xiaolaba/Curve_Tracer_testing/(threads)

Thread 1 (2021-10-04):

License violation

JosephEoff, 2021-10-04:
Hi.  It is rather cool that you like my software enough  to repost it with some useful batch files.

It is not so cool that you changed the license.

"Rodriguez" is licensed under  the [GNU General Public License, version 2.](https://www.gnu.org/licenses/old-licenses/gpl-2.0.en.html)

Your repository has the license set to MIT.  By the terms of the GPL, only the copyright holder (me, Joseph Eoff) can change the license.

Please change the license on the repository to GPL V2, or delete the repository.

JosephEoff, 2021-10-04:
Additionally, there is a binary build of Rodriguez in my repository ([Release 1.0.0](https://github.com/JosephEoff/Rodriguez/releases/tag/v1.0.0)) so there's no real need to provide a binary of your own.

xiaolaba, 2021-10-04:
thanks. i had delete the license and add another, please teach me whether the license is sutible one for the choice.

JosephEoff, 2021-10-04:
Thank you for fixing the license.

GPL V2.0 is the correct license.

The GPL V20 license requires that you keep the same license when using code licensed under it.  The GPL V2 license also requires that you make the code itself available to other users.  You have a link to my project in the ReadMe.  I'll accept that as "providing the source code."

You don't need to refer to this in your ReadMe.  Just keep the license as is, and make sure to always refer to my project so that others can find the most current version.

JosephEoff, 2021-10-05:
I saw that you had some trouble with negative values for the diode and collector current.

Both are caused by the same thing.

The real cause is that I swapped A2 and A3 when I drew the schematics.  That made the calculated values for the collector current come out negative.  The diode function uses the same analog inputs as the collector measurements, so that messed up the diode measurements as well.

Since you are the second person to have this problem, I changed the Arduino code to use the analog inputs as shown in the schematic diagrams.

All you need to do is to download the new Rodriguez.ino file and burn it to your Arduino.

xiaolaba, 2021-10-06:
thanks Joseph,we will try out later on when come back to town.

JosephEoff, 2021-10-13:
You will have to show me what you mean about "redundant" CRLF.

The Rodriguez Arduino part uses the [Arduino Serial.println](https://www.arduino.cc/reference/en/language/functions/communication/serial/println/) function, which always sends a CRLF at the end of each line.

It reads individual characters, ignoring line ends and reacting only to the command codes (B or C.)

The Python program uses serial.readline, which reads the lines sent to it from the Arduino.  This works correctly und Linux.  It should also work correctly under Windows.

Where are you seeing redundant CRLF?

Closed 2021-10-04.
