xiaolaba/Curve_Tracer_testing/curve tracer design reading/DIY Generic Curve Tracer - Electronics-Lab.pdf

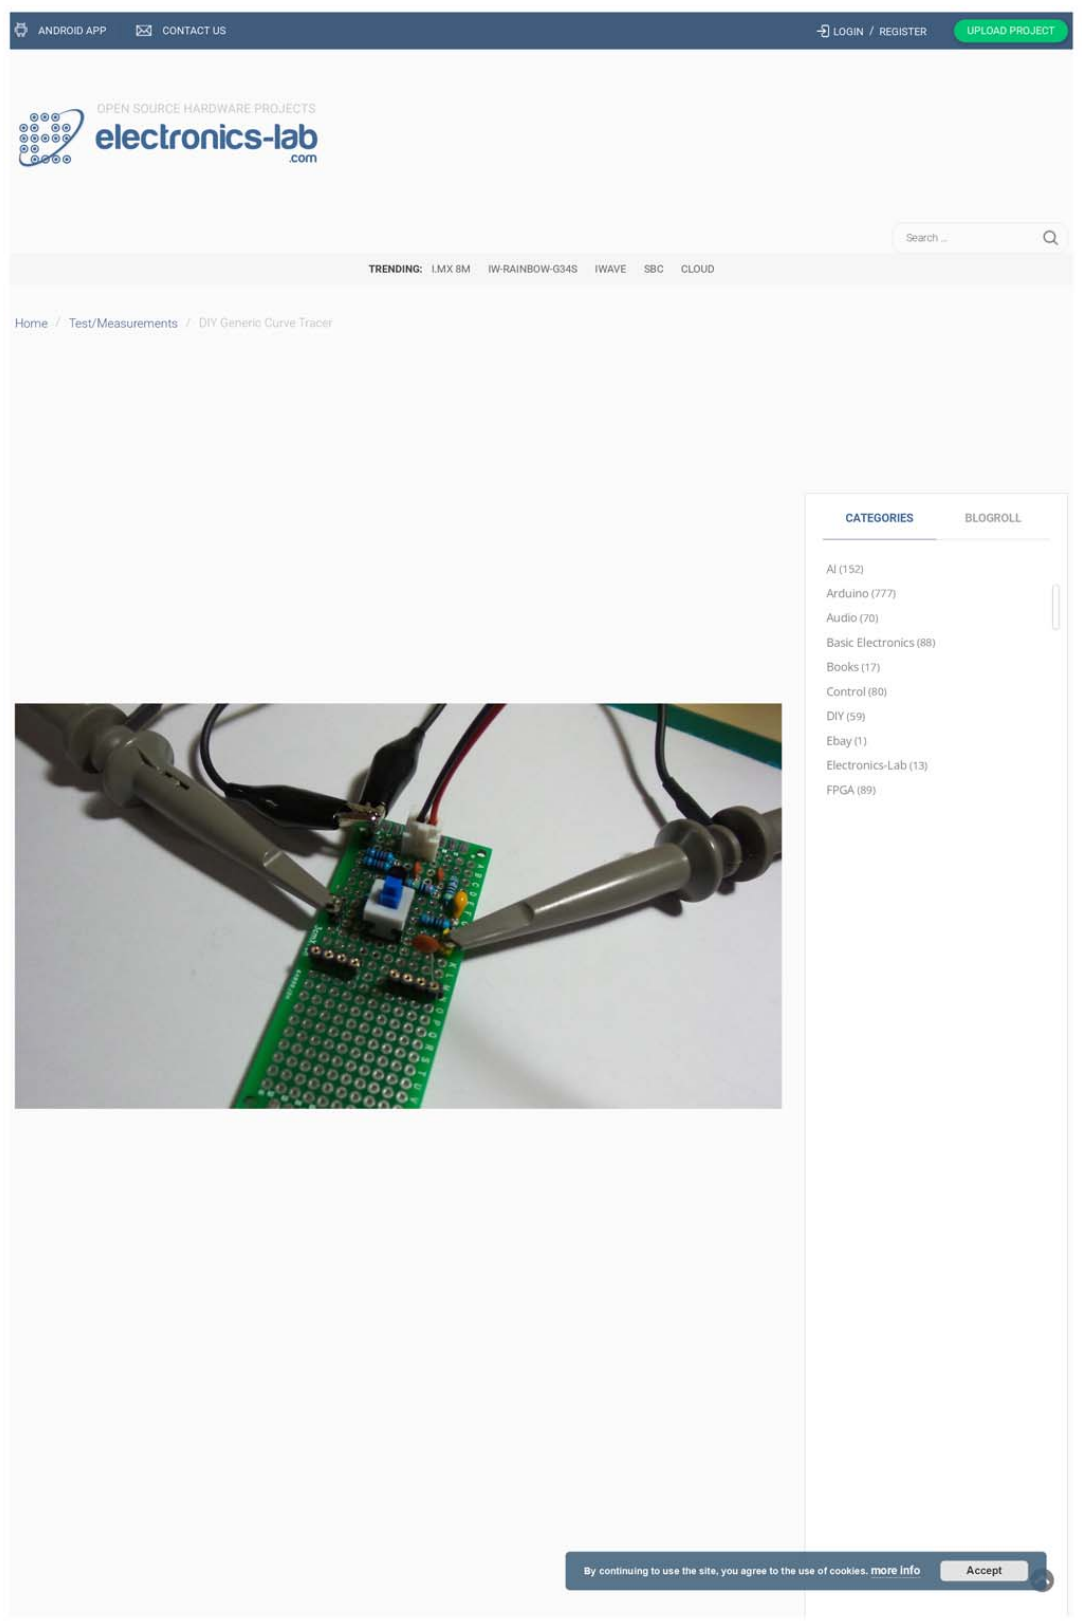
[picture p19: page 1]

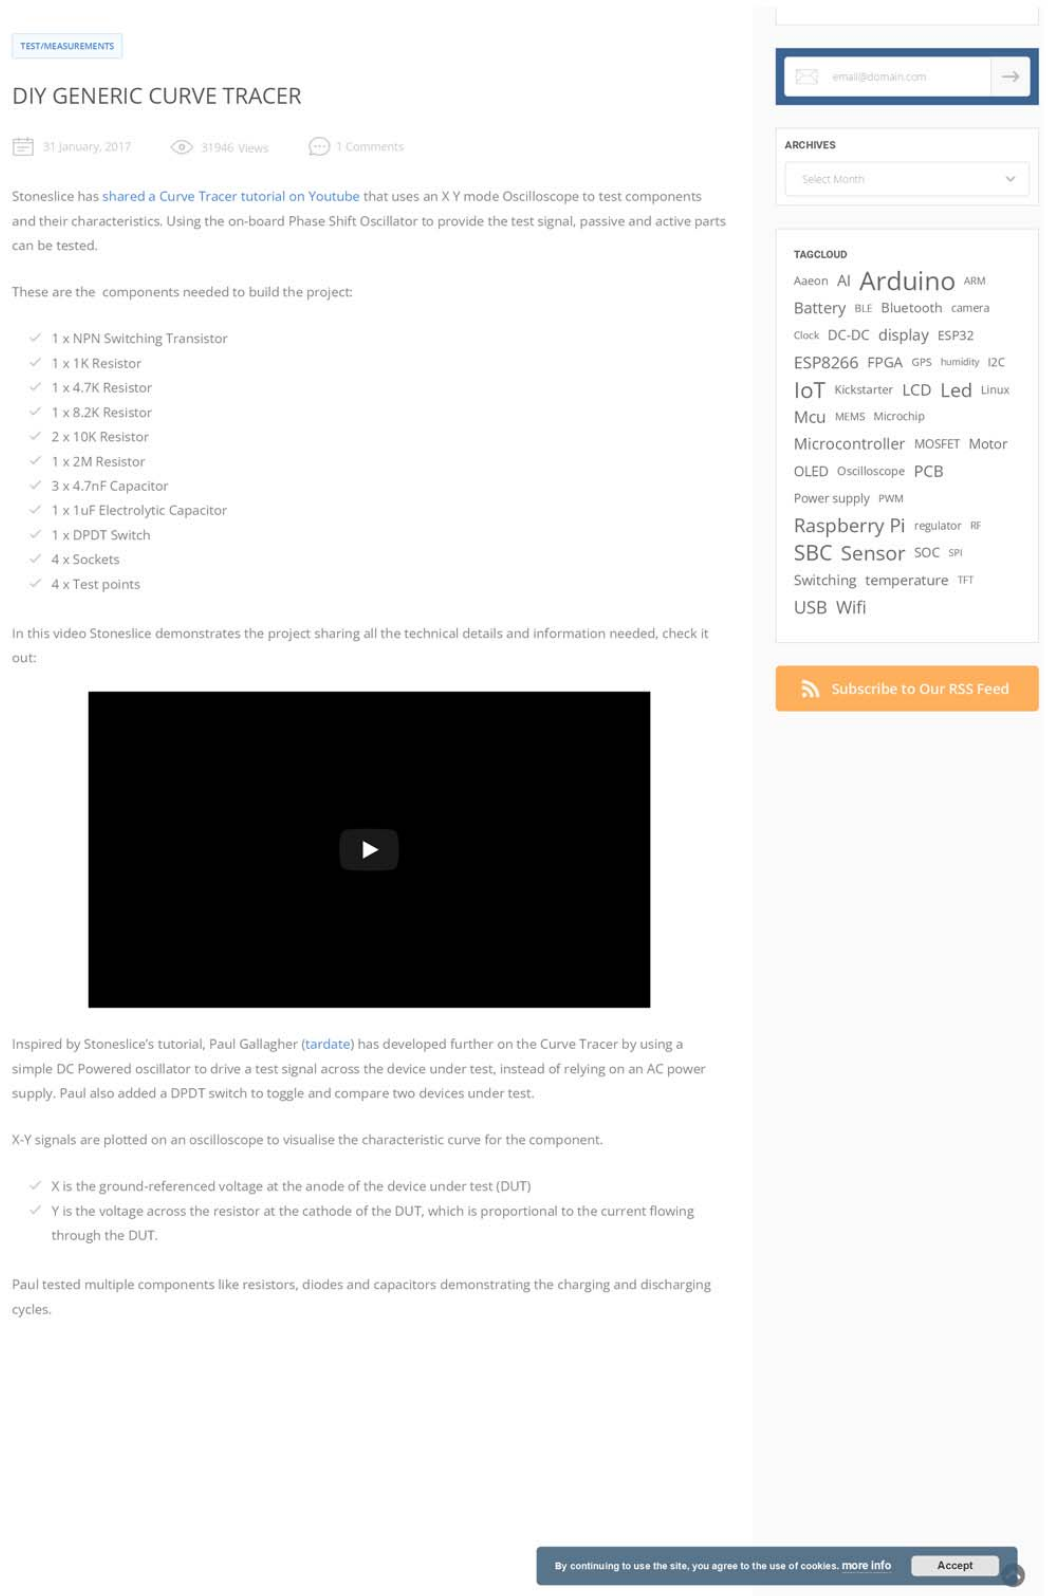
[picture p20: page 2]

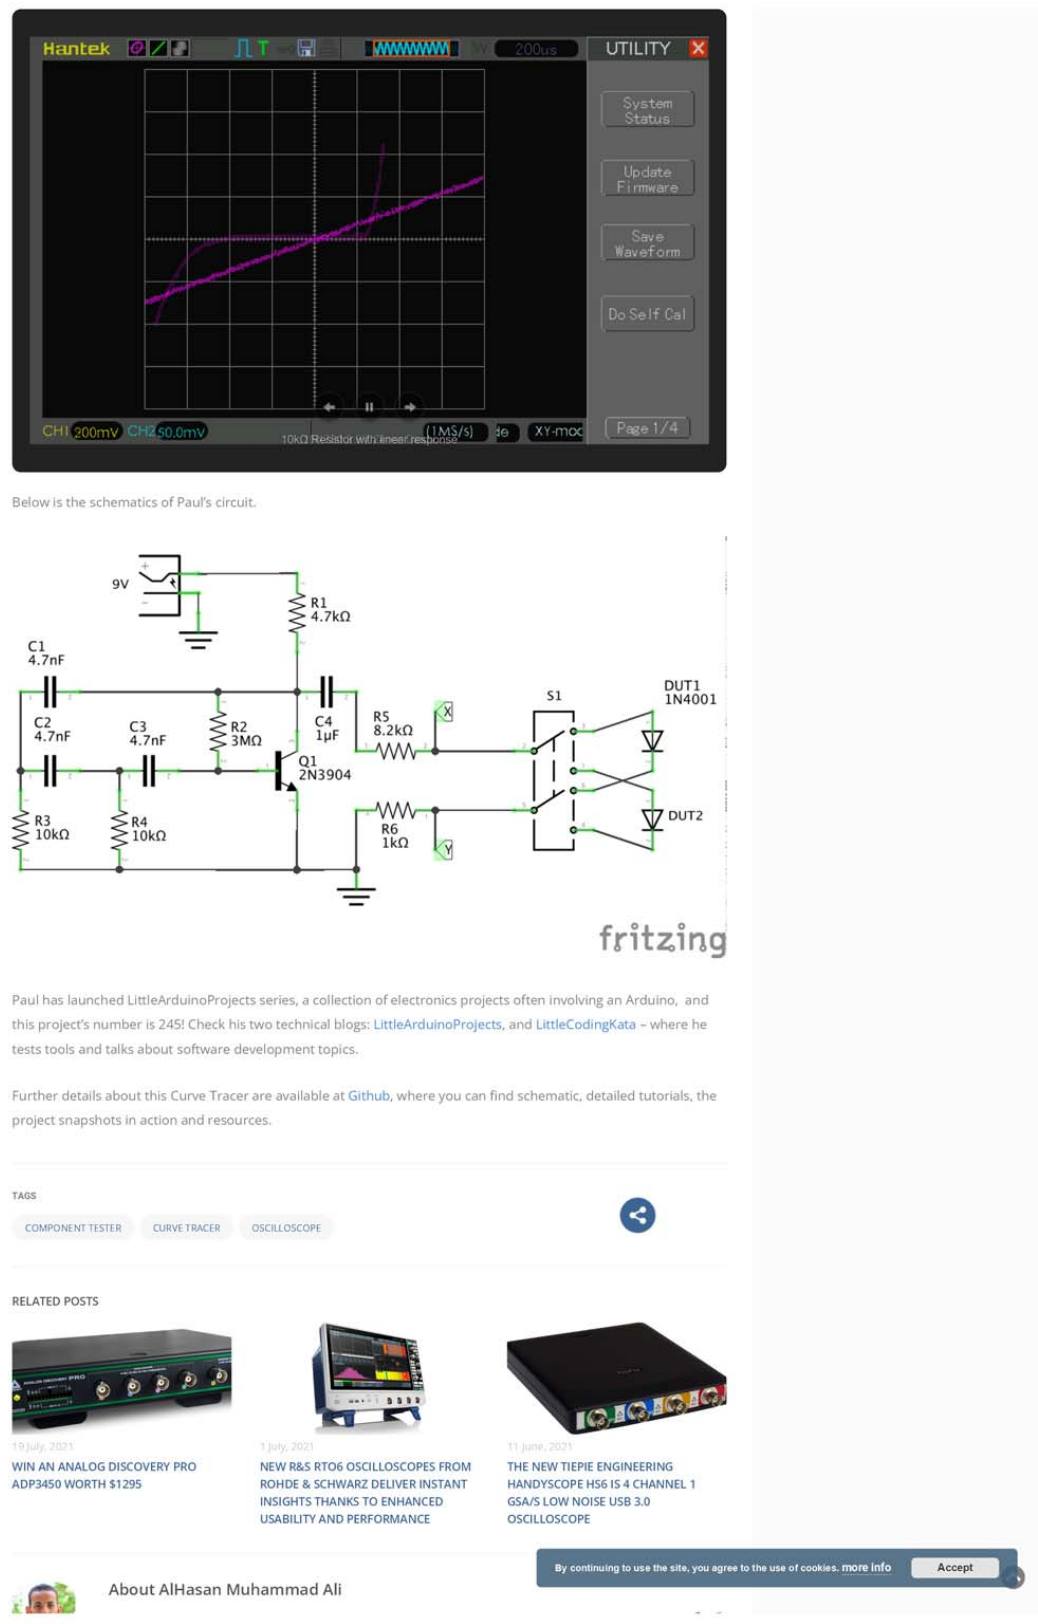
[picture p21: page 3]

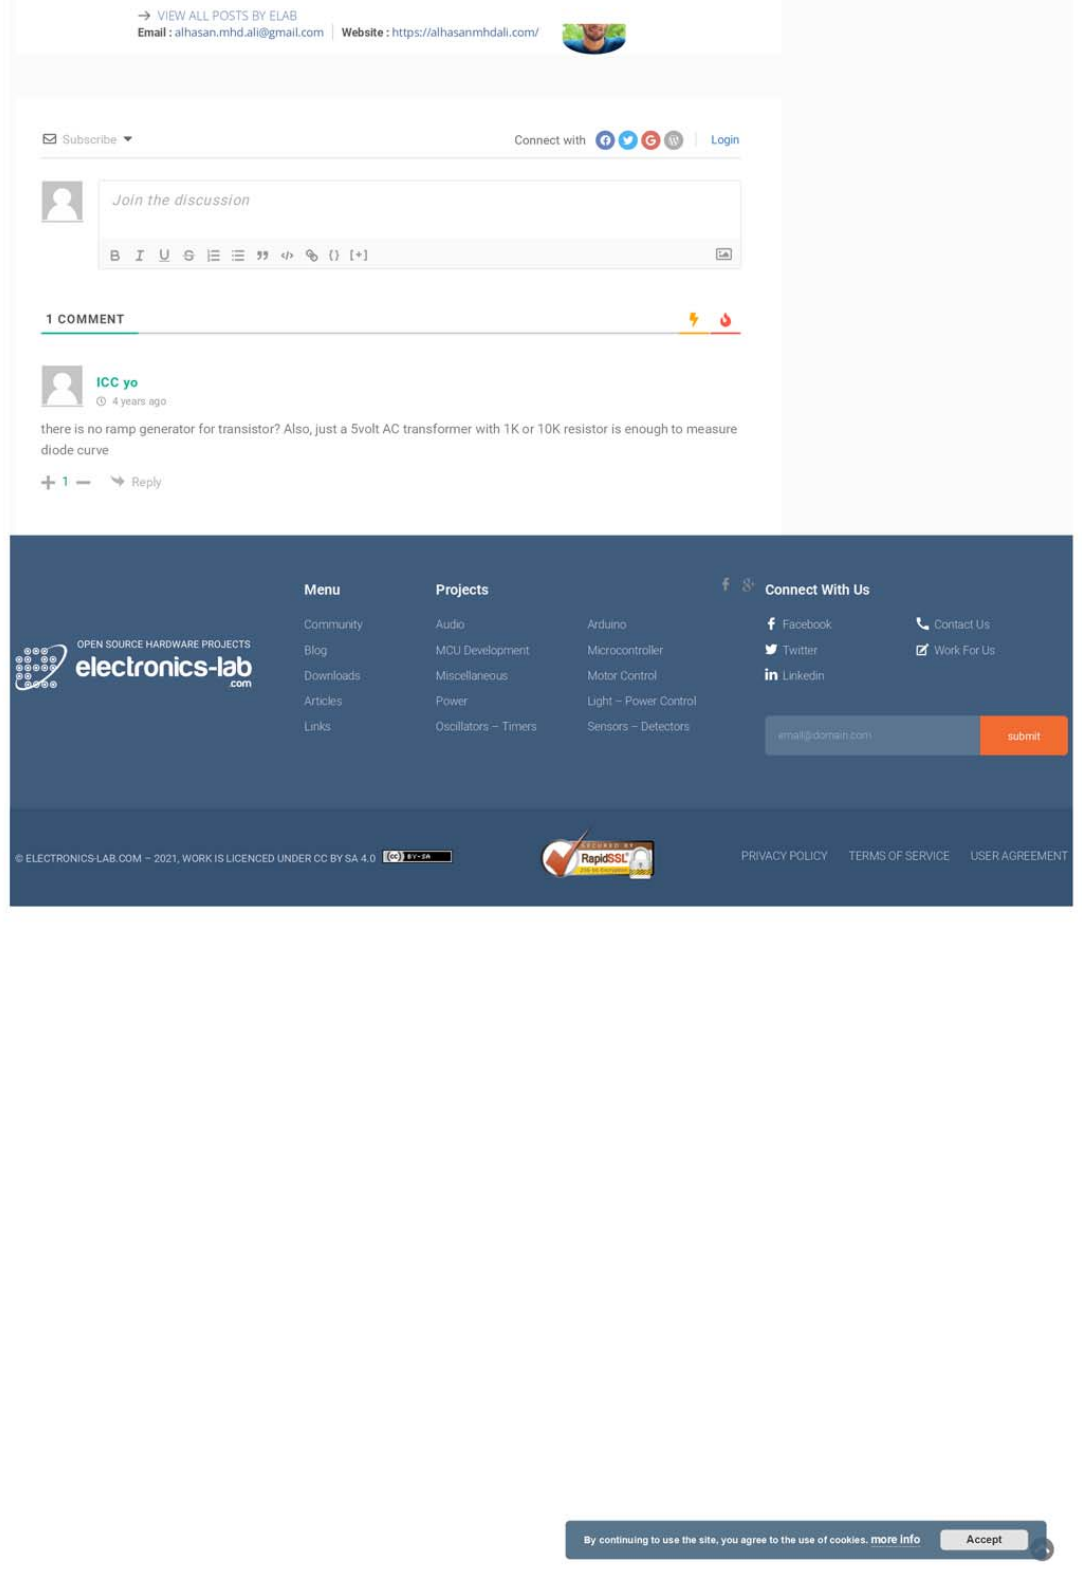
[picture p22: page 4]
