xiaolaba/Curve_Tracer_testing/curve tracer design reading/I Curve Tracer – I – Kerry D.pdf

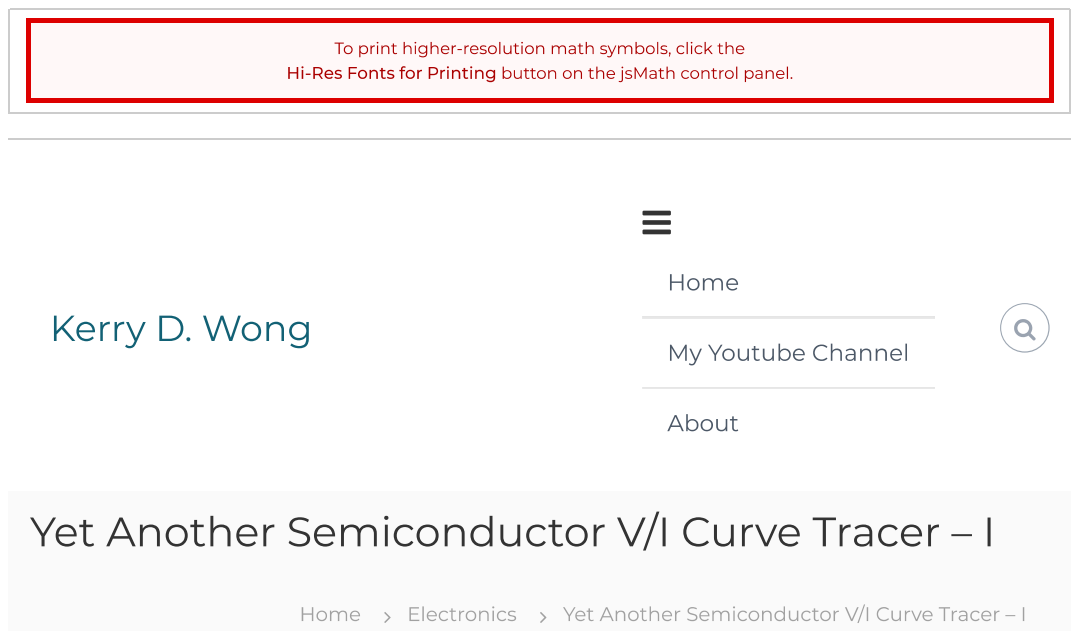
[picture p23: page 1]

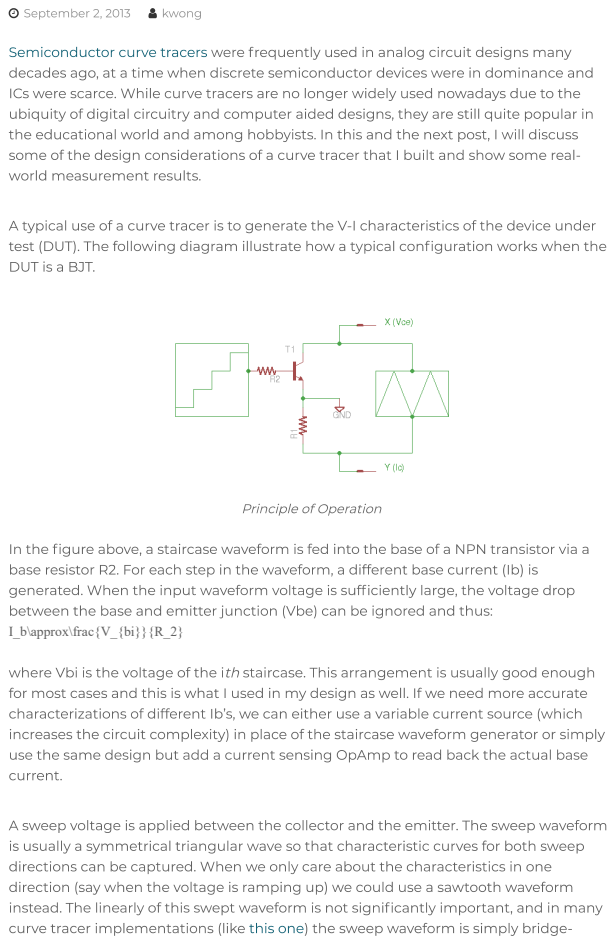
[picture p24: page 2]

I_b\approx\frac{V_{bi}}{R_2}

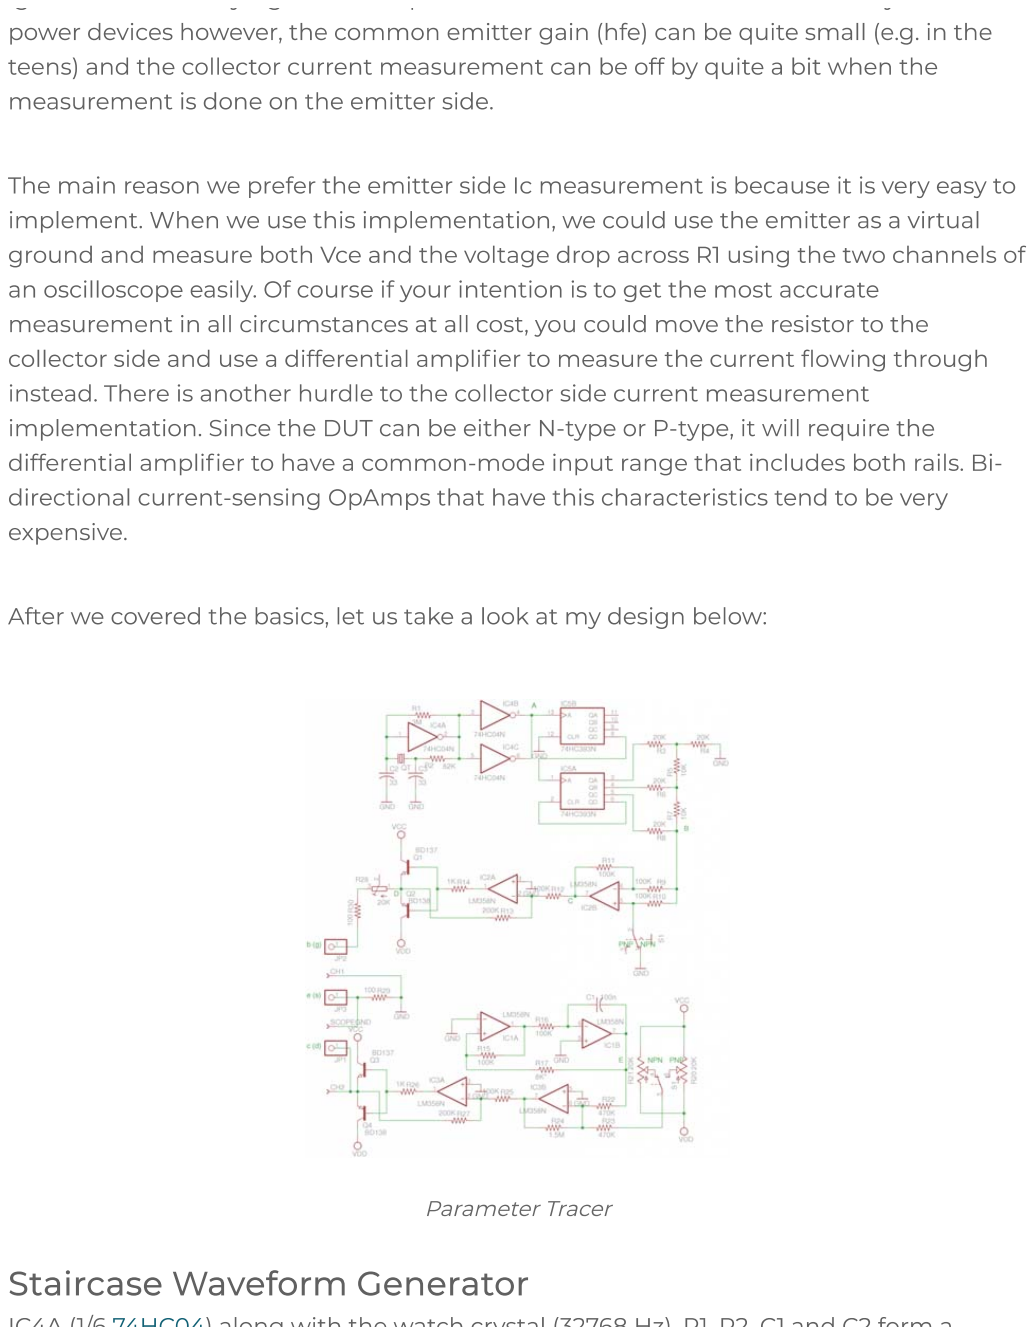
[picture p25: page 3]

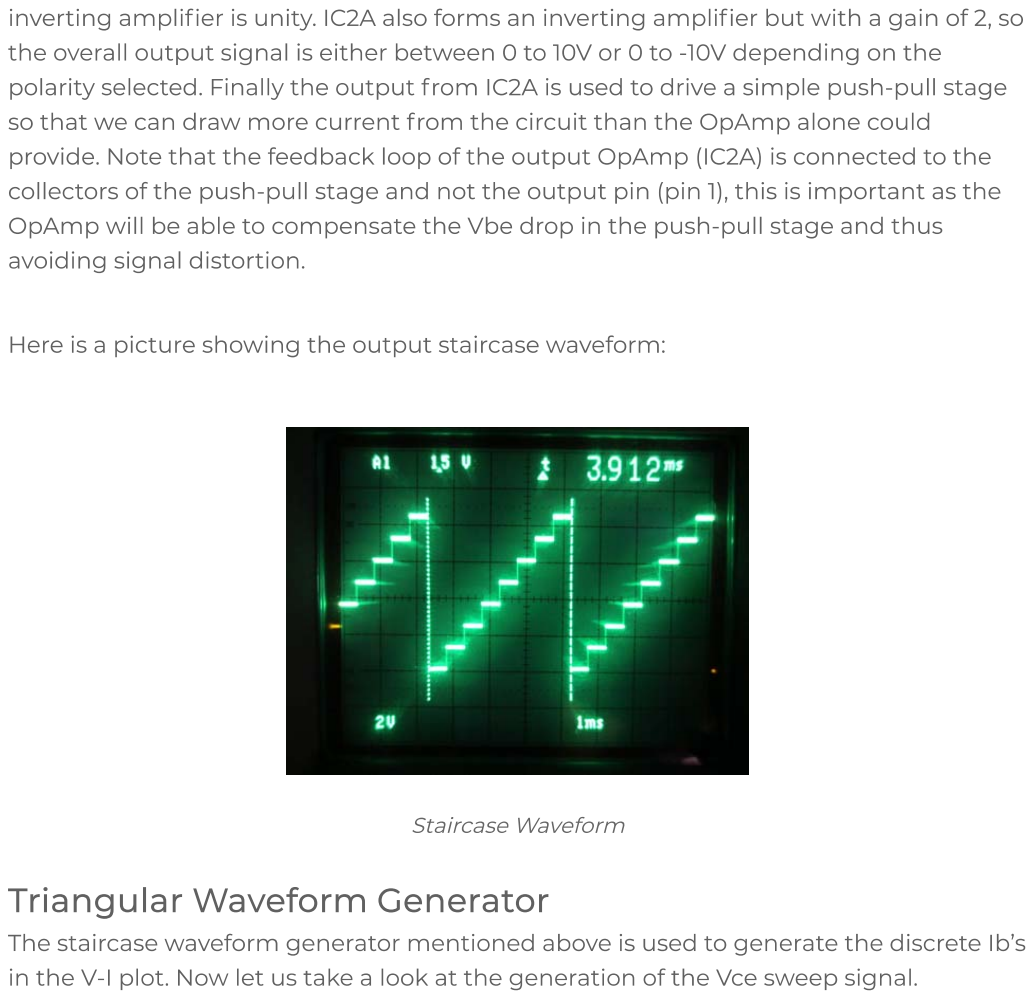
[picture p26: page 4]

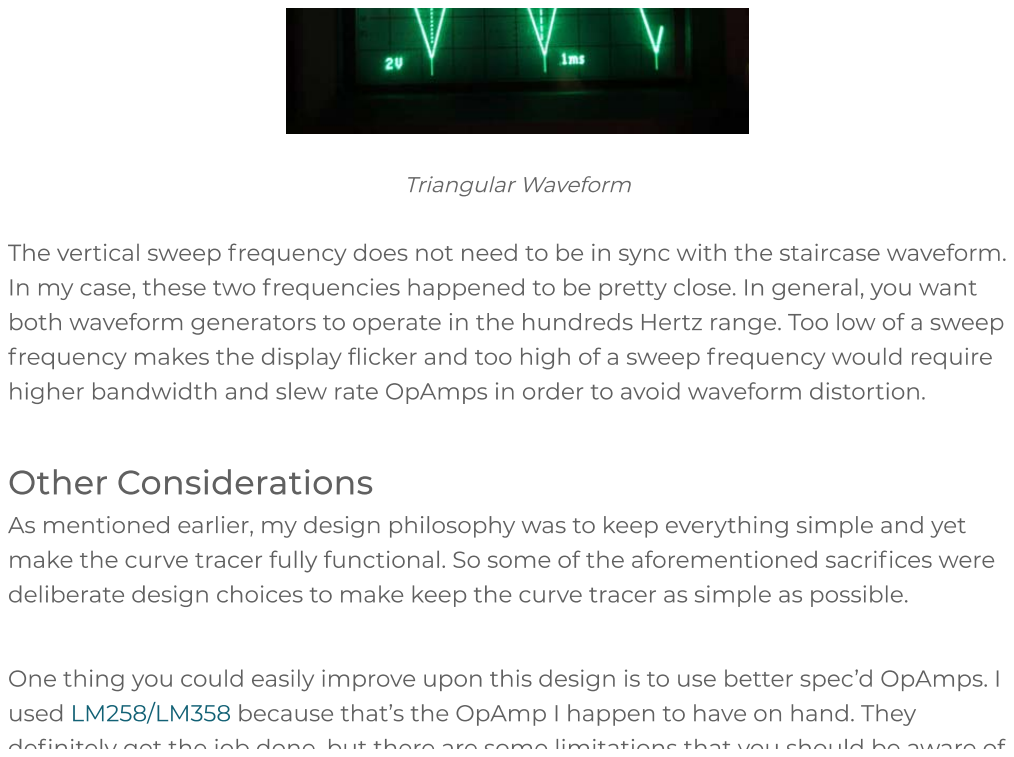
[picture p27: page 5]

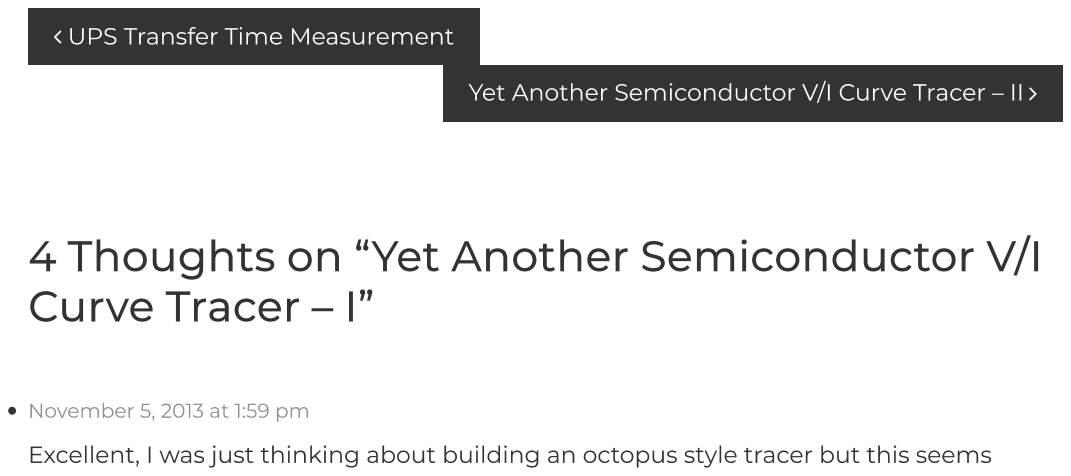
[picture p28: page 6]

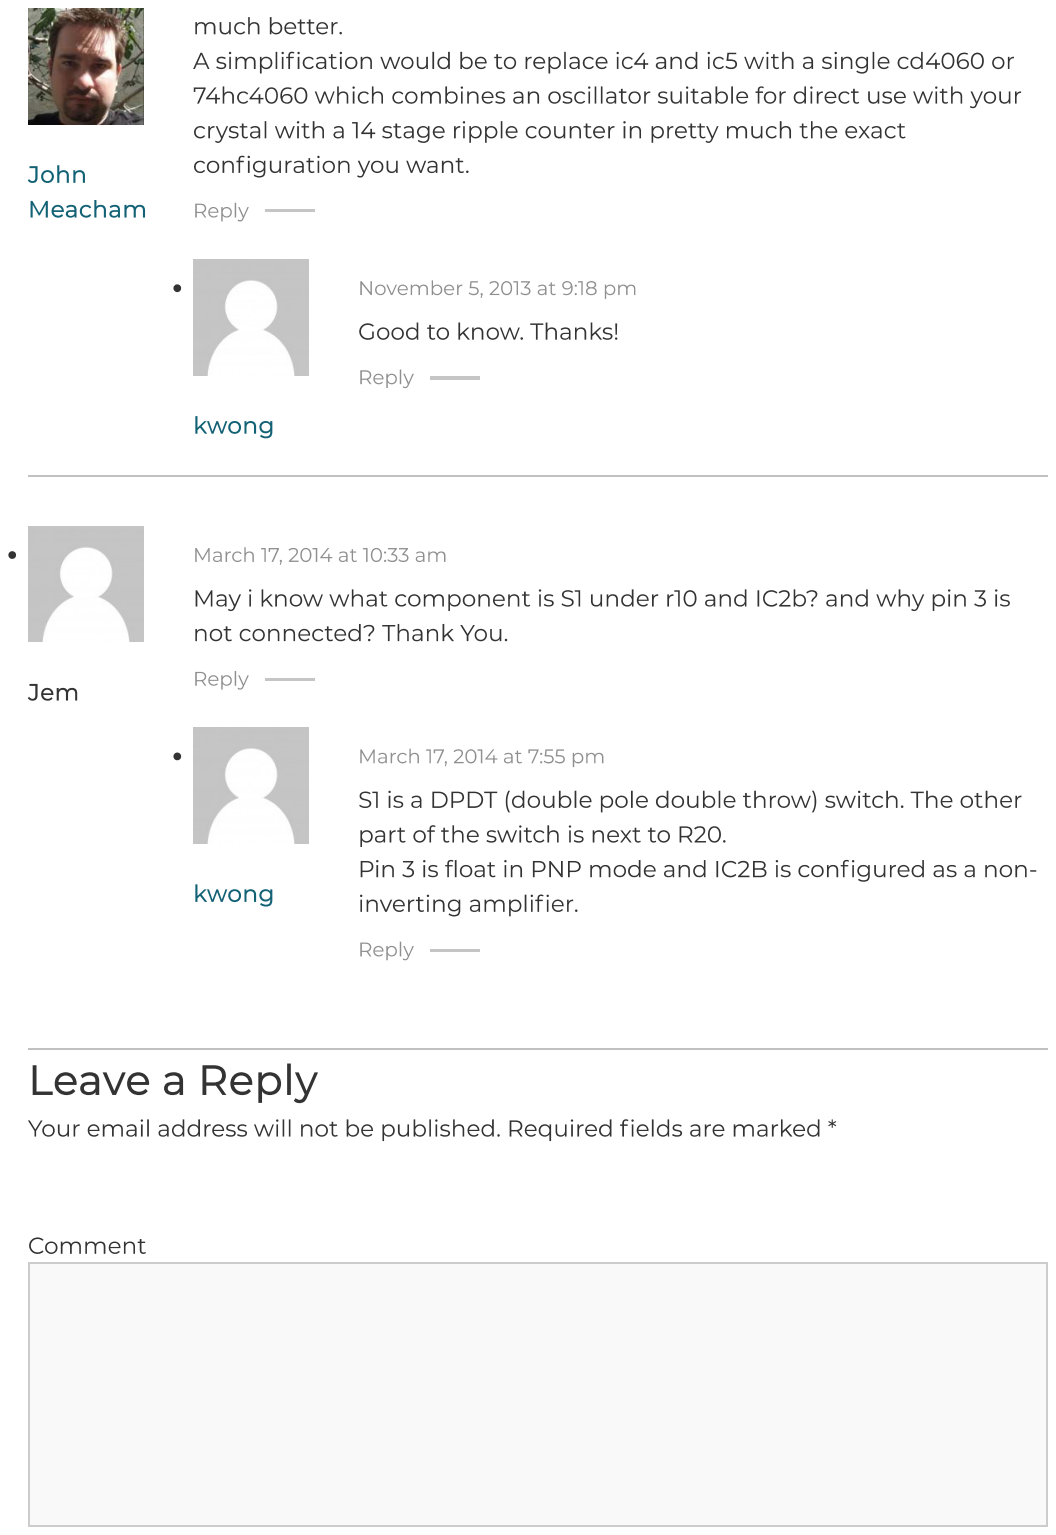
[picture p29: page 7]

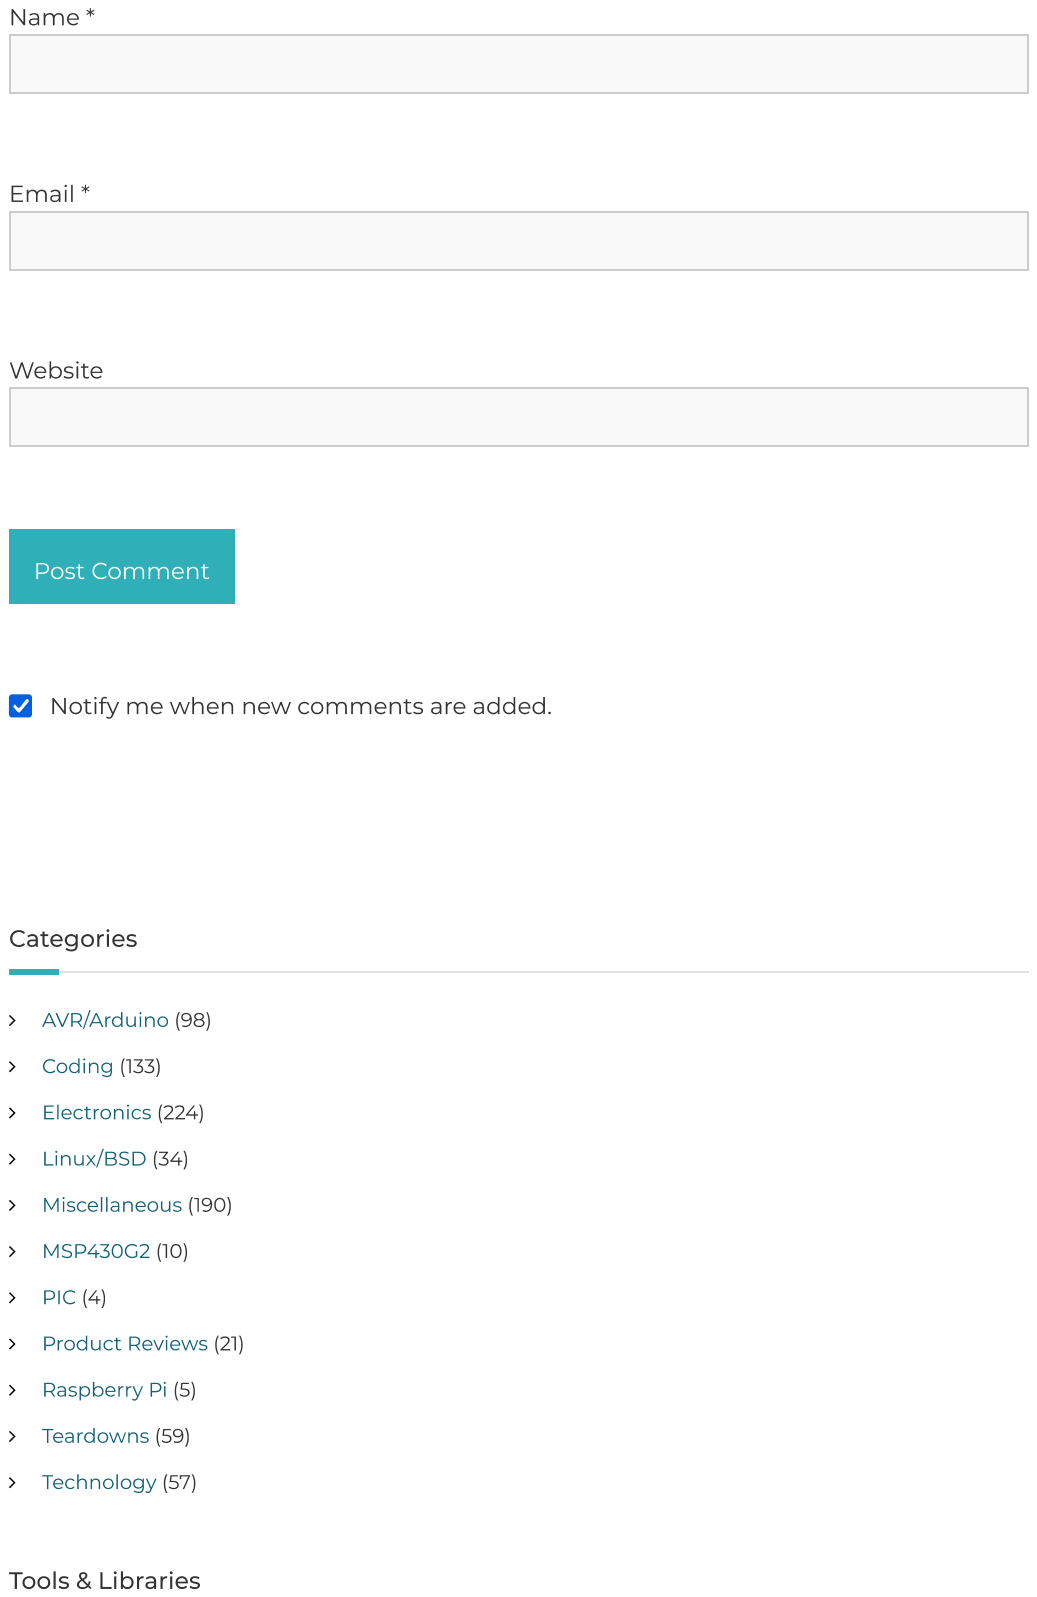
[picture p30: page 8]

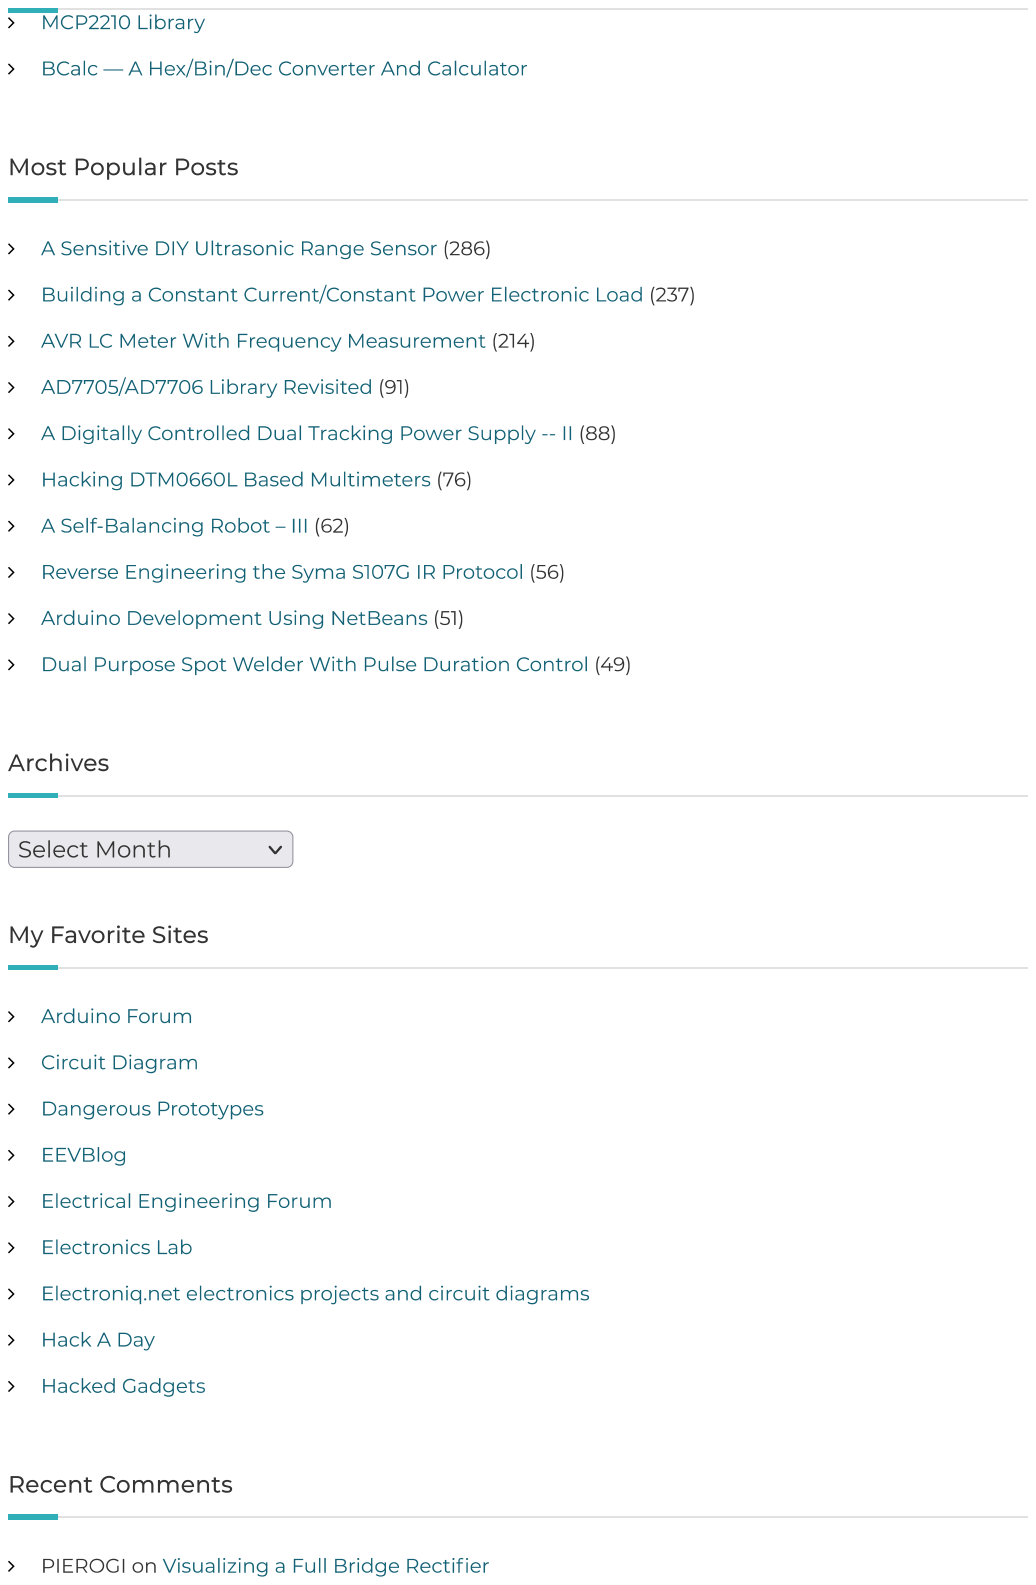
[picture p31: page 9]

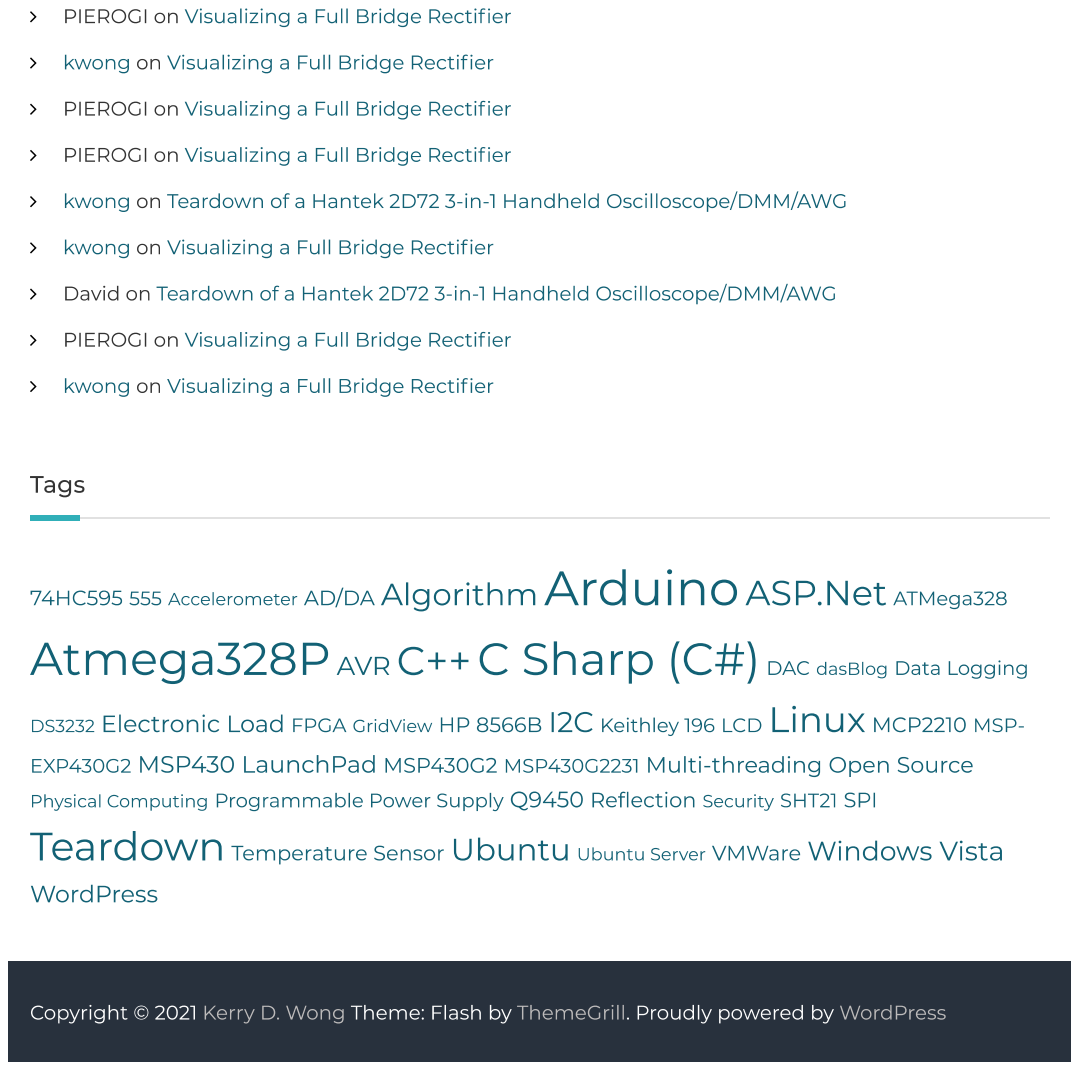
[picture p32: page 10]
