xiaolaba/Curve_Tracer_testing/(commit log)

2021-10-04 my traces were odd.
2021-10-04 my traces were odds
2021-10-04 upload circuit diagram
2021-10-04 pin# atmega328p ISP
2021-10-04 LED trace
2021-10-05 arduino code bug and why
2021-10-05 hex code for filtering
2021-10-06 curve tracer design reading
2021-10-26 1st IV plot
    1st IV plot, update schematic
